UCSBRoboticsClub/micromouse-2015/README

CONTRIBUTORS
Austin
Gauthier
Charles
Patrick
Tirion
Nickolas
