UCSBRoboticsClub/micromouse-2015/pcb/lipo-shutoff.brd

## EAGLE design pcb/lipo-shutoff.brd (2015-05-03)

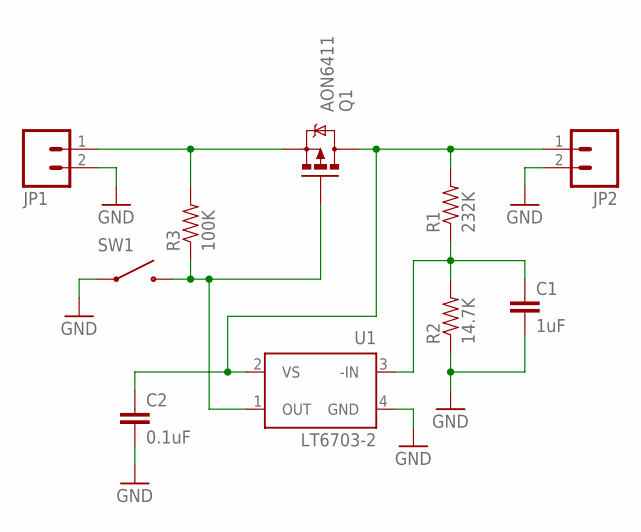
[picture p1: schematic lipo-shutoff.sch]

Parts:
C1: 1uF; 0603-CAP
C2: 0.1uF; 0603-CAP
JP1, JP2: M02LOCK_LONGPADS; 1X02_LOCK_LONGPADS
Q1: AON6411; DFN5X6
R1: 232K; 0603-RES
R2: 14.7K; 0603-RES
R3: 100K; 0603-RES
SW1: FSM4JSMA
U1: LT6703-2; LT6703

Connections:
GND: C1.2, C2.2, JP1.2, JP2.2, R2.1, SW1.1, SW1.2 (1), U1.4 (GND)
unnamed: JP1.1, Q1.1 (S), Q1.2 (S), Q1.3 (S), R3.2
unnamed: Q1.4 (G), R3.1, SW1.3 (2), SW1.4 (2), U1.1 (OUT)
unnamed: C2.1, JP2.1, Q1.5 (D), Q1.6 (D), Q1.7 (D), Q1.8 (D), Q1.PAD (D), R1.2, U1.2 (VS)
unnamed: C1.1, R1.1, R2.2, U1.3 (-IN)

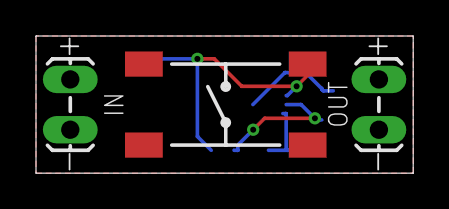
[picture p2: board lipo-shutoff.brd from above]

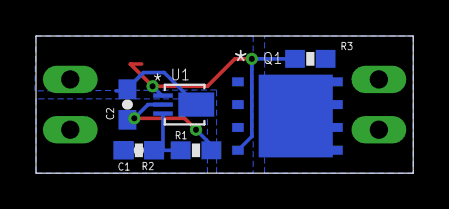
[picture p3: board lipo-shutoff.brd from below]

Board: 2 copper layers, 21.0 x 7.6 mm, 10 parts (7 on the bottom side), 5 nets.
