UCSBRoboticsClub/micromouse-2015/pcb/micromouse.brd

## EAGLE design pcb/micromouse.brd (2015-03-07)

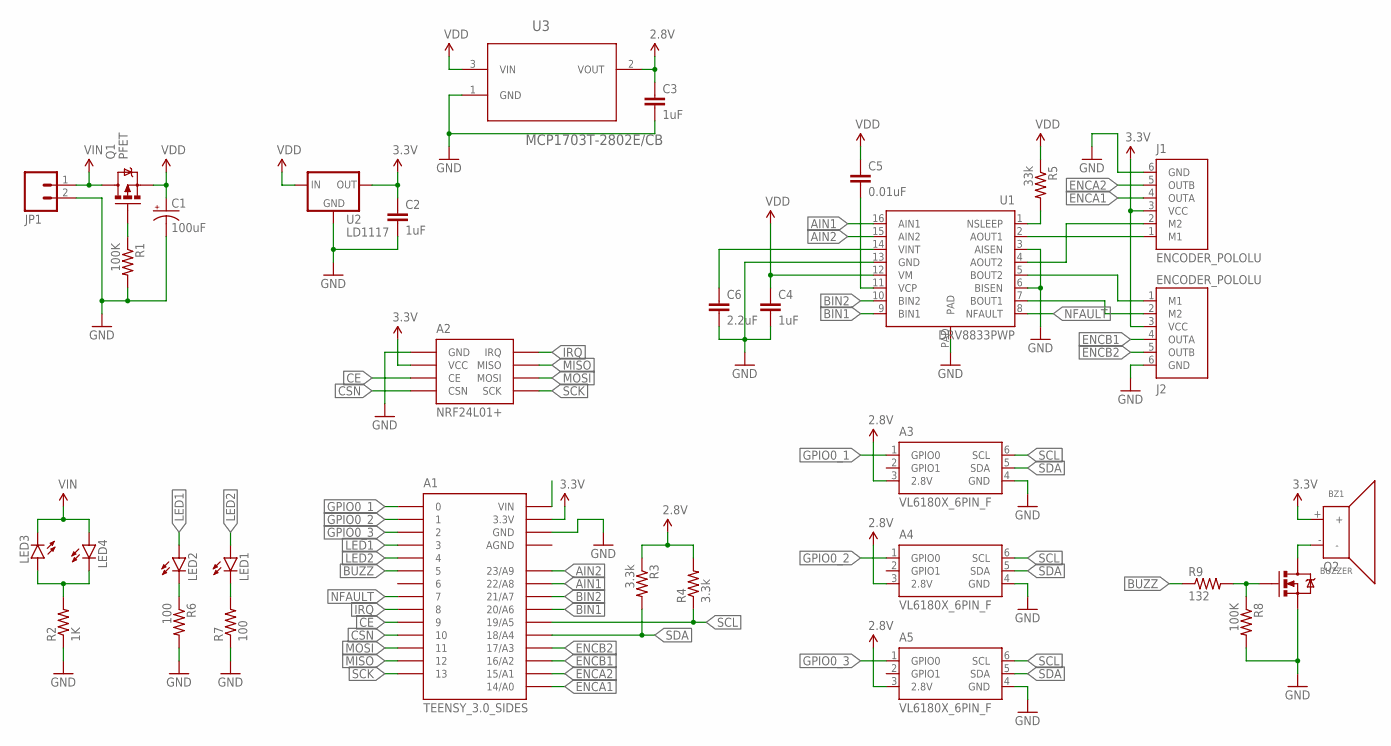
[picture p4: schematic micromouse.sch]

Parts:
A1: TEENSY_3.0_SIDES
A2: NRF24L01+
A3, A4, A5: VL6180X_6PIN_F; 2X3HEADER
BZ1: BUZZER
C1: 100uF; CPOL-RADIAL-100UF-25V
C2, C3, C4: 1uF; 0603-CAP
C5: 0.01uF; 0603-CAP
C6: 2.2uF; 0603-CAP
J1, J2: ENCODER_POLOLU; 1XM06-LOCK
JP1: M02LOCK_LONGPADS; 1X02_LOCK_LONGPADS
LED1, LED2, LED3, LED4: LED0603; LED-0603
Q1: PFET; SOT23-3
Q2: MOSFET-NCHANNELBSS123LT1G; SOT23-3
R1, R8: 100K; 0603-RES
R2: 1K; 0603-RES
R3, R4: 3.3k; 0603-RES
R5: 33k; 0603-RES
R6, R7: 100; 0603-RES
R9: 132; 0603-RES
U1: DRV8833PWP; HTSSOP-16
U2: LD1117; SOT-223
U3: MCP1703T-2802E/CB; SOT95P300X145-3N

Connections:
2.8V: A3.3 (2.8V), A4.3 (2.8V), A5.3 (2.8V), C3.1, R3.1, R4.2, U3.2 (VOUT)
3.3V: A1.3.3V, A2.2 (VCC), BZ1.+, C2.1, J1.3 (VCC), J2.3 (VCC), U2.2 (OUT), U2.4 (OUT)
AGND: A1.AGND
AIN1: A1.22/A8, U1.16 (AIN1)
AIN2: A1.23/A9, U1.15 (AIN2)
BIN1: A1.20/A6, U1.9 (BIN1)
BIN2: A1.21/A7, U1.10 (BIN2)
BUZZ: A1.5, R9.1
CE: A1.9, A2.3 (CE)
CSN: A1.10, A2.4 (CSN)
ENCA1: A1.14/A0, J1.4 (OUTA)
ENCA2: A1.15/A1, J1.5 (OUTB)
ENCB1: A1.16/A2, J2.4 (OUTA)
ENCB2: A1.17/A3, J2.5 (OUTB)
GND: A1.GND, A2.1 (GND), A3.4 (GND), A4.4 (GND), A5.4 (GND), C1.2 (-), C2.2, C3.2, C4.2, C6.2, J1.6 (GND), J2.6 (GND), JP1.2, Q2.2 (S), R1.2, R2.1, R6.2, R7.1, R8.2, U1.3 (AISEN), U1.6 (BISEN), U1.13 (GND), U1.PAD, U2.1 (GND), U3.1 (GND)
GPIO0_1: A1.0, A3.1 (GPIO0)
GPIO0_2: A1.1, A4.1 (GPIO0)
GPIO0_3: A1.2, A5.1 (GPIO0)
IRQ: A1.8, A2.8 (IRQ)
LED1: A1.3, LED2.A
LED2: A1.4, LED1.A
MISO: A1.12, A2.7 (MISO)
MOSI: A1.11, A2.6 (MOSI)
unnamed: Q1.1 (G), R1.1
unnamed: LED3.A, LED4.C, R2.2
unnamed: J1.1 (M1), U1.2 (AOUT1)
unnamed: LED2.C, R6.1
unnamed: J1.2 (M2), U1.4 (AOUT2)
unnamed: J2.1 (M1), U1.5 (BOUT2)
unnamed: BZ1.-, Q2.3 (D)
unnamed: J2.2 (M2), U1.7 (BOUT1)
unnamed: R5.2, U1.1 (NSLEEP)
unnamed: C6.1, U1.14 (VINT)
unnamed: C5.2, U1.11 (VCP)
unnamed: LED1.C, R7.2
unnamed: Q2.1 (G), R8.1, R9.2
NFAULT: A1.7, U1.8 (NFAULT)
SCK: A1.13, A2.5 (SCK)
SCL: A1.19/A5, A3.6 (SCL), A4.6 (SCL), A5.6 (SCL), R4.1
SDA: A1.18/A4, A3.5 (SDA), A4.5 (SDA), A5.5 (SDA), R3.2
VDD: C1.1 (+), C4.1, C5.1, Q1.2 (S), R5.1, U1.12 (VM), U2.3 (IN), U3.3 (VIN)
VIN: JP1.1, LED3.C, LED4.A, Q1.3 (D)

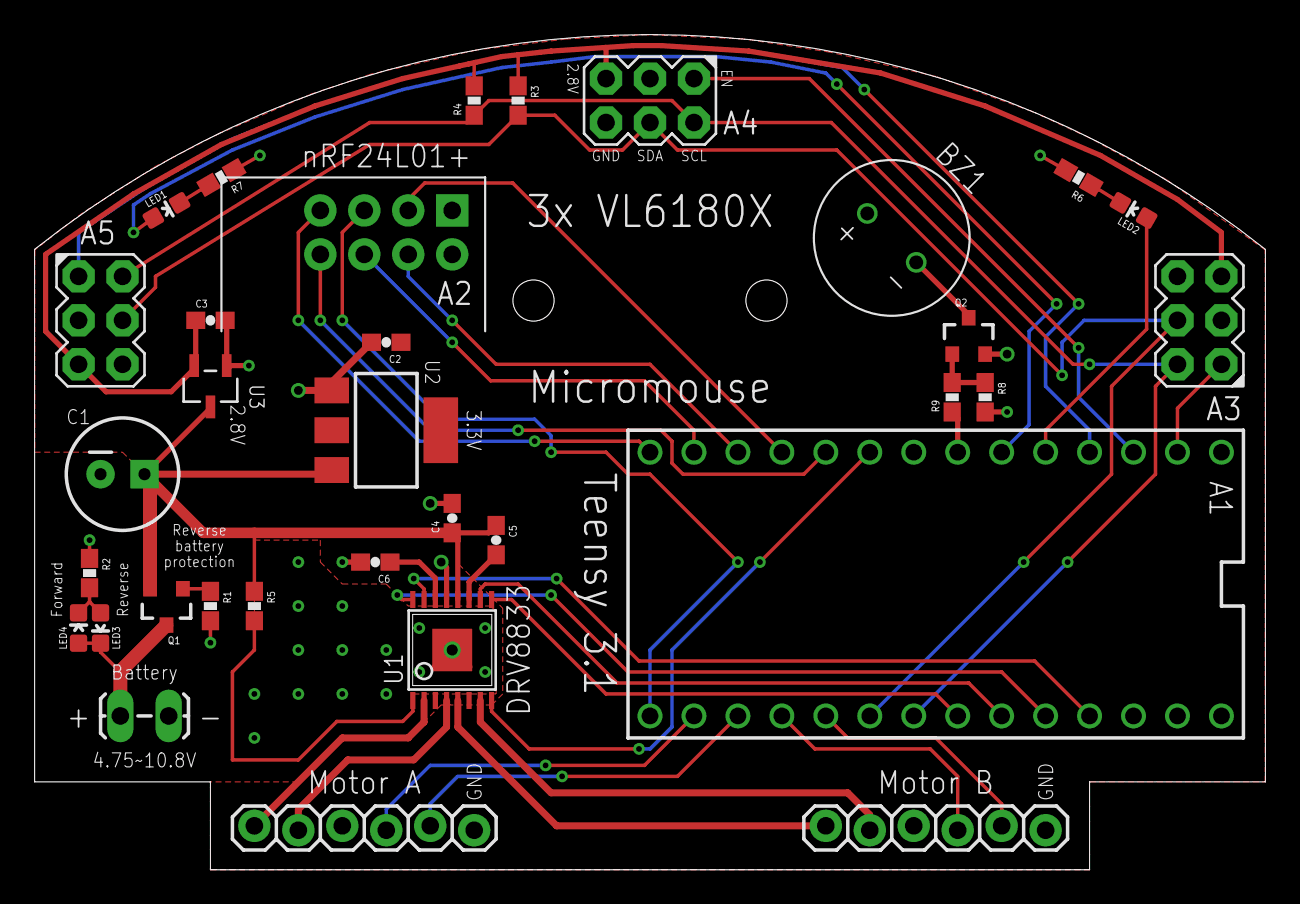
[picture p5: board micromouse.brd from above]

Board: 2 copper layers, 71.1 x 48.3 mm, 33 parts (0 on the bottom side), 41 nets.
