UCSBRoboticsClub/micromouse-2015/pcb/comparator.brd

## EAGLE design pcb/comparator.brd (2015-03-06)

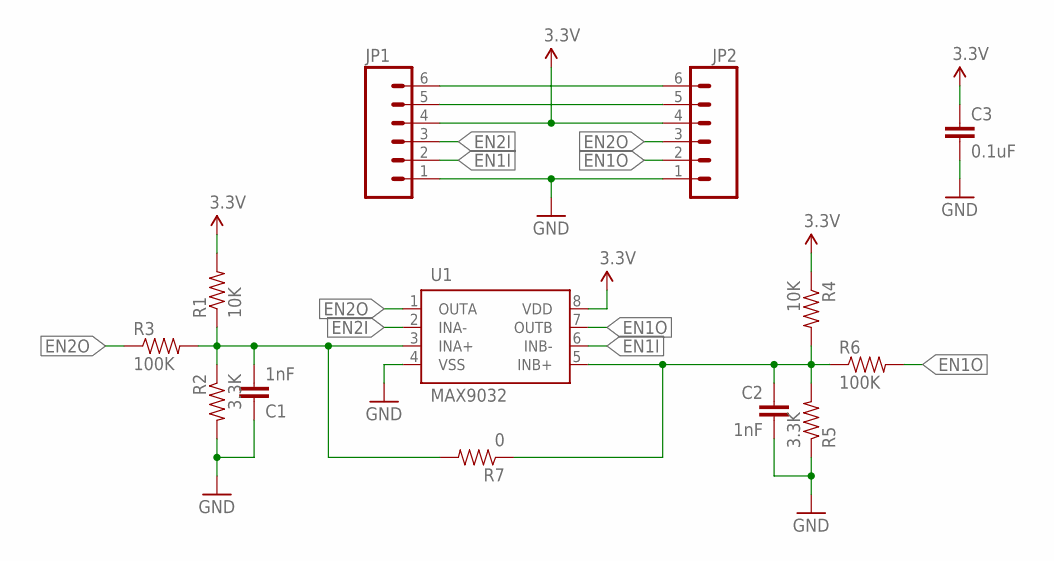
[picture p6: schematic comparator.sch]

Parts:
C1, C2: 1nF; 0603-CAP
C3: 0.1uF; 0603-CAP
JP1: M06SMDF; 1X06-SMD-FEMALE
JP2: M06LOCK; 1X06_LOCK
R1, R4: 10K; 0603-RES
R2, R5: 3.3K; 0603-RES
R3, R6: 100K; 0603-RES
R7: 0; 0603-RES
U1: MAX9032; SOT23-8

Connections:
3.3V: C3.1, JP1.4, JP2.4, R1.2, R4.1, U1.8 (VDD)
EN1I: JP1.2, U1.6 (INB-)
EN1O: JP2.2, R6.2, U1.7 (OUTB)
EN2I: JP1.3, U1.2 (INA-)
EN2O: JP2.3, R3.1, U1.1 (OUTA)
GND: C1.1, C2.2, C3.2, JP1.1, JP2.1, R2.2, R5.1, U1.4 (VSS)
unnamed: JP1.6, JP2.6
unnamed: JP1.5, JP2.5
unnamed: C1.2, R1.1, R2.1, R3.2, R7.2, U1.3 (INA+)
unnamed: C2.1, R4.2, R5.2, R6.1, R7.1, U1.5 (INB+)

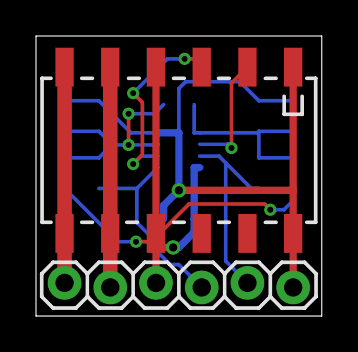
[picture p7: board comparator.brd from above]

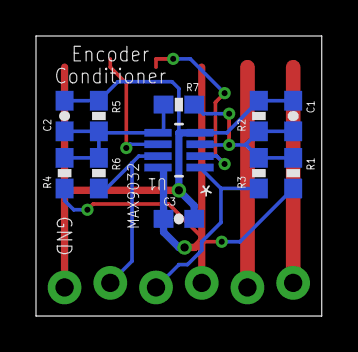
[picture p8: board comparator.brd from below]

Board: 2 copper layers, 15.9 x 15.6 mm, 13 parts (11 on the bottom side), 10 nets.
