UCSBRoboticsClub/micromouse-2015/pcb/vl6180x.brd

## EAGLE design pcb/vl6180x.brd (2015-03-02)

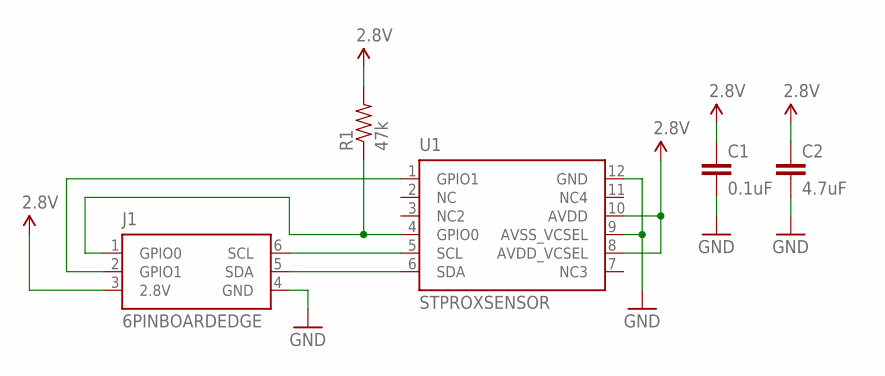
[picture p9: schematic vl6180x.sch]

Parts:
C1: 0.1uF; 0603-CAP
C2: 4.7uF; 0603-CAP
J1: 6PINBOARDEDGE
R1: 47k; 0603-RES
U1: STPROXSENSOR

Connections:
2.8V: C1.1, C2.1, J1.3 (2.8V), R1.2, U1.8 (AVDD_VCSEL), U1.10 (AVDD)
GND: C1.2, C2.2, J1.4 (GND), U1.9 (AVSS_VCSEL), U1.12 (GND)
unnamed: J1.1 (GPIO0), R1.1, U1.4 (GPIO0)
unnamed: J1.6 (SCL), U1.5 (SCL)
unnamed: J1.5 (SDA), U1.6 (SDA)
unnamed: J1.2 (GPIO1), U1.1 (GPIO1)

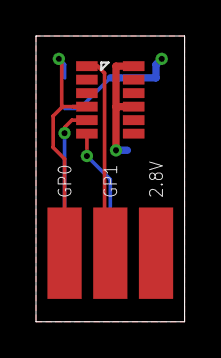
[picture p10: board vl6180x.brd from above]

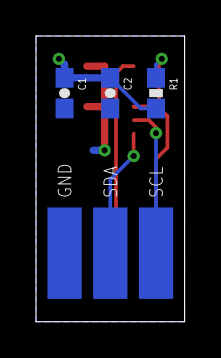
[picture p11: board vl6180x.brd from below]

Board: 2 copper layers, 8.3 x 15.9 mm, 5 parts (3 on the bottom side), 6 nets.
