UCSBRoboticsClub/micromouse-2015/Micromouse2015/Wheel.h

#ifndef WHEEL_H
#define WHEEL_H

#include <Encoder.h>
#include "LowPass.h"
#include "drv8833.h"
#include "PIDController.h"


class Wheel
{
public:
    Wheel(int motPin1,
          int motPin2,
          int encPin1,
          int encPin2,
          float dt,
          float circumference,
          int cpr);
    void update();
    void setVelocity(float vel);
    float getVelocity();
    void setPosition(float pos);
    float getPosition();
    void zeroPosition();
    int getCounts();
    
    PIDController velocityLoop;
    PIDController positionLoop;
    float velocityKd;
    
//private:
    Motor motor;
    Encoder encoder;
    int lastCount;
    LowPass velocity;
    LowPass acceleration;
    bool positionMode;
    float velocitySetpoint;
    float positionSetpoint;
    const float dt;
    const float count2dist;

    float velocityControl;
};

#endif // WHEEL_H
