UCSBRoboticsClub/micromouse-2015/Micromouse2015/Songs.cpp

#include "Songs.h"
#include "Globals.h"
#include <Arduino.h>
#include <cstring>
#include <cstdlib>


void playSong(const char *s)
{
    while (s != NULL)
    {
        s = std::strchr(s, 'f');
        if (s == NULL) break;
        int f = std::strtol(++s, const_cast<char**>(&s), 10);
        if (s == NULL)  break;
        s = std::strchr(s, 't');
        if (s == NULL)  break;
        int t = std::strtol(++s, const_cast<char**>(&s), 10);

        if (f > 0)
            tone(buzzerPin, f);
        else
            noTone(buzzerPin);
        
        delay(t);

        if (button1.pressed())
        {
            noTone(buzzerPin);
            return;
        }
    }
    
    noTone(buzzerPin);
}


const char recorder[] = "f622t2 f698t168 f0t209 f698t107 f0t29 f698t121 f0t8 f698t617 f0t166 | f740t162 f0t66 f698t168 f0t64 f698t39 f659t88 f698t20 f0t21 f740t18 f0t84 f698t2 f740t119 f698t16 f659t23 f0t80 f698t74 f740t33 f784t21 f740t23 f0t135 f784t33 f740t141 f0t72 f659t166 f0t107 f698t252 f0t59 f698t137 f0t63 f698t88 f0t105 f698t111 f0t119 f587t82 f0t166 f587t63 f0t162 f659t117 f0t119 f659t63 f698t113 f0t230 f698t332 f0t588 | f587t66 f0t47 f587t123 f659t113 f698t236 f740t27 f784t43 f831t31 f880t94 f831t51 f784t51 f831t105 f880t96 f831t21 f784t774 f0t480 | f587t67 f0t88 f659t80 f698t78 f0t47 f698t68 f740t25 f784t45 f0t88 f831t31 f880t16 f932t34 f932t33 f880t207 f0t35 f1047t31 f988t50 f932t44 f988t53 f1047t26 f831t2 f880t264 f932t98 f988t109 f932t105 f988t31 f932t125 f0t400 | f622t24 f0t68 f831t47 f880t33 f831t41 f0t70 f831t102 f0t121 f988t27 f1047t14 f0t125 f988t100 f932t29 f880t21 f831t18 f784t96 f831t35 f880t119 f932t2330";

const char startup[] = "f659t250 f0t750 f659t250 f0t750 f1318t750";

/* C4 262 
 * D4 294
 * E4 330
 * F4 349
 * G4 392
 * A5 440
 * A#5 466
 * B5 494
 * C5 523
 * D5 587
 * E5 659
 * F5 698
 * G5 784
 */

const char mortalkombat[] = "f440t250 f440t250 f523t250 f440t250 f587t250 f440t250 f659t250 f587t250 f523t250 f523t250 f659t250 f523t250 f784t250 f523t250 f659t250 f523t250 f392t250 f392t250 f494t250 f392t250 f523t250 f392t250 f587t250 f523t250 f349t250 f349t250 f440t250 f349t250 f523t250 f349t250 f587t250 f523t250 | f440t250 f440t250 f523t250 f440t250 f587t250 f440t250 f659t250 f587t250 f523t250 f523t250 f659t250 f523t250 f784t250 f523t250 f659t250 f523t250 f392t250 f392t250 f494t250 f392t250 f523t250 f392t250 f587t250 f523t250 f349t250 f349t250 f440t250 f349t250 f523t250 f349t250 f587t250 f523t250 | f440t250 f0t125 f440t250 f0t125 f440t250 f0t125 f440t250 f0t125 f392t250 f523t250 f440t250 f0t125 f440t250 f0t125 f440t250 f0t125 f440t250 f0t125 f392t250 f330t250 f440t250 f0t125 f440t250 f0t125 f440t250 f0t125 f440t250 f0t125 f392t250 f523t250 f440t250 f0t125 f440t250 f0t125 f440t250 f440t125 f440t125 f0t125 f440t125 f440t125 f0t375 | f440t250 f0t125 f440t250 f0t125 f440t250 f0t125 f440t250 f0t125 f392t250 f523t250 f440t250 f0t125 f440t250 f0t125 f440t250 f0t125 f440t250 f0t125 f392t250 f330t250 f440t250 f0t125 f440t250 f0t125 f440t250 f0t125 f440t250 f0t125 f392t250 f523t250 f440t250 f0t125 f440t250 f0t125 f440t250 f440t125 f440t125 f0t125 f440t125 f440t125 f0t375 | f440t125 f659t150 f0t100 f440t125 f523t150 f0t100 f440t125 f466t150 f0t100 f440t125 f523t150 f0t100 f440t125 f466t125 f392t150 f0t100 f440t125 f659t150 f0t100 f440t125 f523t150 f0t100 f440t125 f466t150 f0t100 f440t125 f523t150 f0t100 f440t125 f466t125 f392t150 f0t100 f440t125 f659t150 f0t100 f440t125 f523t150 f0t100 f440t125 f466t150 f0t100 f440t125 f523t150 f0t100 f440t125 f466t125 f392t150 f0t100 f440t125 f659t150 f0t100 f440t125 f523t150 f0t100 f392t125 f392t150 f0t100 f392t125 f440t150 f0t100 f440t250 f0t250 | f440t125 f659t150 f0t100 f440t125 f523t150 f0t100 f440t125 f466t150 f0t100 f440t125 f523t150 f0t100 f440t125 f466t125 f392t150 f0t100 f440t125 f659t150 f0t100 f440t125 f523t150 f0t100 f440t125 f466t150 f0t100 f440t125 f523t150 f0t100 f440t125 f466t125 f392t150 f0t100 f440t125 f659t150 f0t100 f440t125 f523t150 f0t100 f440t125 f466t150 f0t100 f440t125 f523t150 f0t100 f440t125 f466t125 f392t150 f0t100 f440t125 f659t150 f0t100 f440t125 f523t150 f0t100 f392t125 f392t150 f0t100 f392t125 f440t150 f0t100 f440t250 f0t250 | f622t250 f0t250 f622t250 f0t250 f622t250 f0t250 f622t250 f0t250 | f587t3875 f0t125 f523t3875 f0t125 f587t3875 f0t125 f523t3875 f0t125";
