UCSBRoboticsClub/micromouse-2015/(commit log)

2015-02-07 Added micromouse pcb schematic
    [micromouse.sch]
2015-02-07 Added distance sensor schematics and board designs
    [vl6180x.brd, vl6180x.sch]
2015-02-07 Added pin labels to proximity sensor board
    [vl6180x.brd]
2015-02-07 Made labels bigger
    [vl6180x.brd]
2015-02-15 Added micromouse pcb layout
    [micromouse.brd, micromouse.sch]
2015-02-16 Added buzzer
    [micromouse.brd, micromouse.sch]
2015-02-16 Improved buzzer drive circuitry
    [micromouse.brd, micromouse.sch]
2015-02-16 Added encoder comparator board
    [comparator.brd, comparator.sch]
2015-02-16 Tweaked encoder conditiner board
    [comparator.brd, comparator.sch]
2015-03-02 Fixed 2.8v regulator pinout
    [micromouse.brd, micromouse.sch, vl6180x.brd, vl6180x.sch]
2015-03-04 Changed led resistors
    [micromouse.brd, micromouse.sch]
2015-03-05 Ported over code from 2014 repository, added music playing through buzzer
    [ControlLoop.cpp, ControlLoop.h, Micromouse2015.ino, Wheel.cpp, Wheel.h]
2015-03-05 Added test code for mouse sensor
2015-03-06 Specified capacitor value on comparator boards
    [comparator.brd, comparator.sch]
2015-03-06 Tuned velocity loop
2015-03-07 Fixed and cleaned up code
    [Globals.cpp, Micromouse2015.ino, Songs.cpp]
2015-03-07 Added range sensor app note
2015-03-07 Fixed nsleep signal on board
    [micromouse.brd, micromouse.sch]
2015-03-07 Fixed build errors and warnings
    [ControlLoop.cpp, ControlLoop.h, Micromouse2015.ino, Wheel.cpp]
2015-03-07 Added parameter print command
2015-03-08 Added BFS and maze files -- requires teensyduino 1.21
2015-03-09 Test BFS performance -- ~2us worst case
2015-03-09 Added battery protection board
    [lipo-shutoff.brd, lipo-shutoff.sch]
2015-03-17 Fixed filter constant calculation in simulation
2015-04-23 Added position tracking using encoders
2015-04-23 Added line needed for float printf on newer teensyduino versions
2015-04-25 Implemented state correction using distance sensors
    [Globals.cpp, Micromouse2015.ino]
2015-05-03 Fixed lipo cutoff board
    [lipo-shutoff.brd, lipo-shutoff.sch]
2015-05-03 Fixed a few things
    [Globals.cpp, Micromouse2015.ino]
2015-05-04 No longer have to call writeLog() in the main loop
    [Micromouse2015.ino]
2015-05-05 Added maze printout
2015-05-05 Fixed some motion planning bugs
    [Globals.cpp, Micromouse2015.ino]
2015-05-05 Front sensor determines whether wall is in this cell or next
2015-05-09 Button board works
2015-05-09 Switch 1 disables filling in maze walls
2015-05-09 Press button 1 to abort run and restart at start cell
2015-05-10 Can increase speed after resetting
    [Micromouse2015.ino]
